zivohayon-eng/Manual-Adjustable-Workpiece-Fixture/Images/Analysis/LeadScrew__FOS.jpg

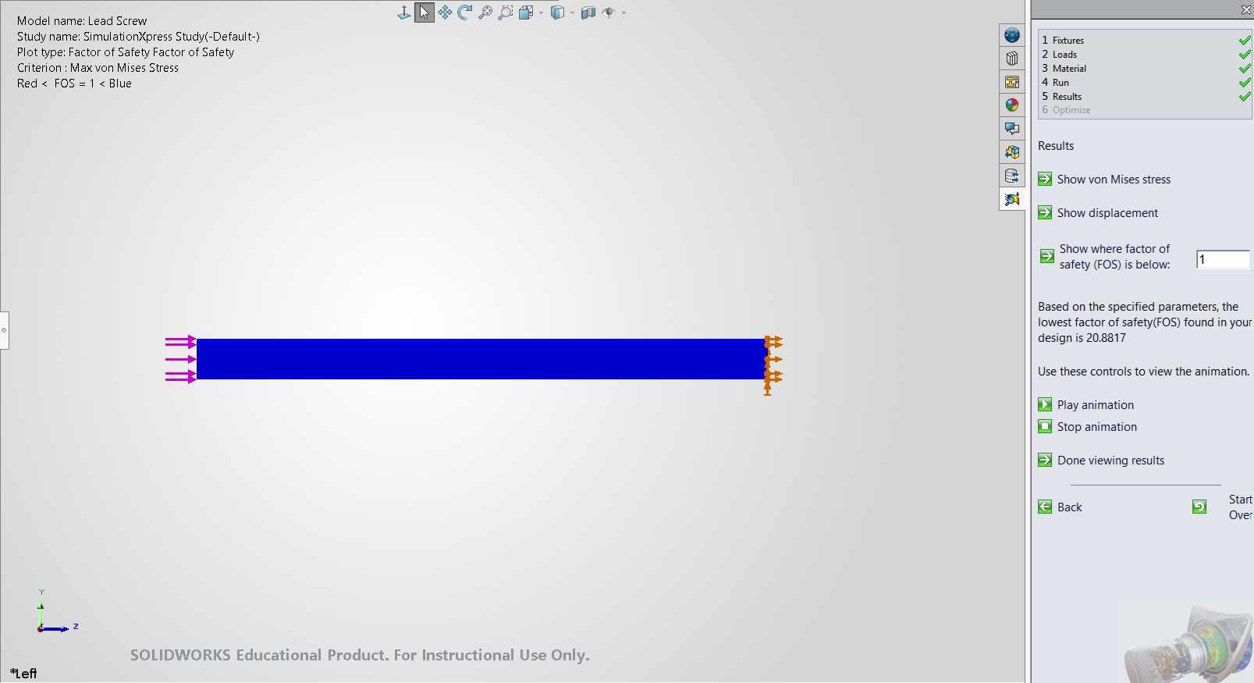
Images/Analysis/LeadScrew__FOS.jpg
