zivohayon-eng/Manual-Adjustable-Workpiece-Fixture/Images/Analysis/LeadScrew_Displacement.jpg

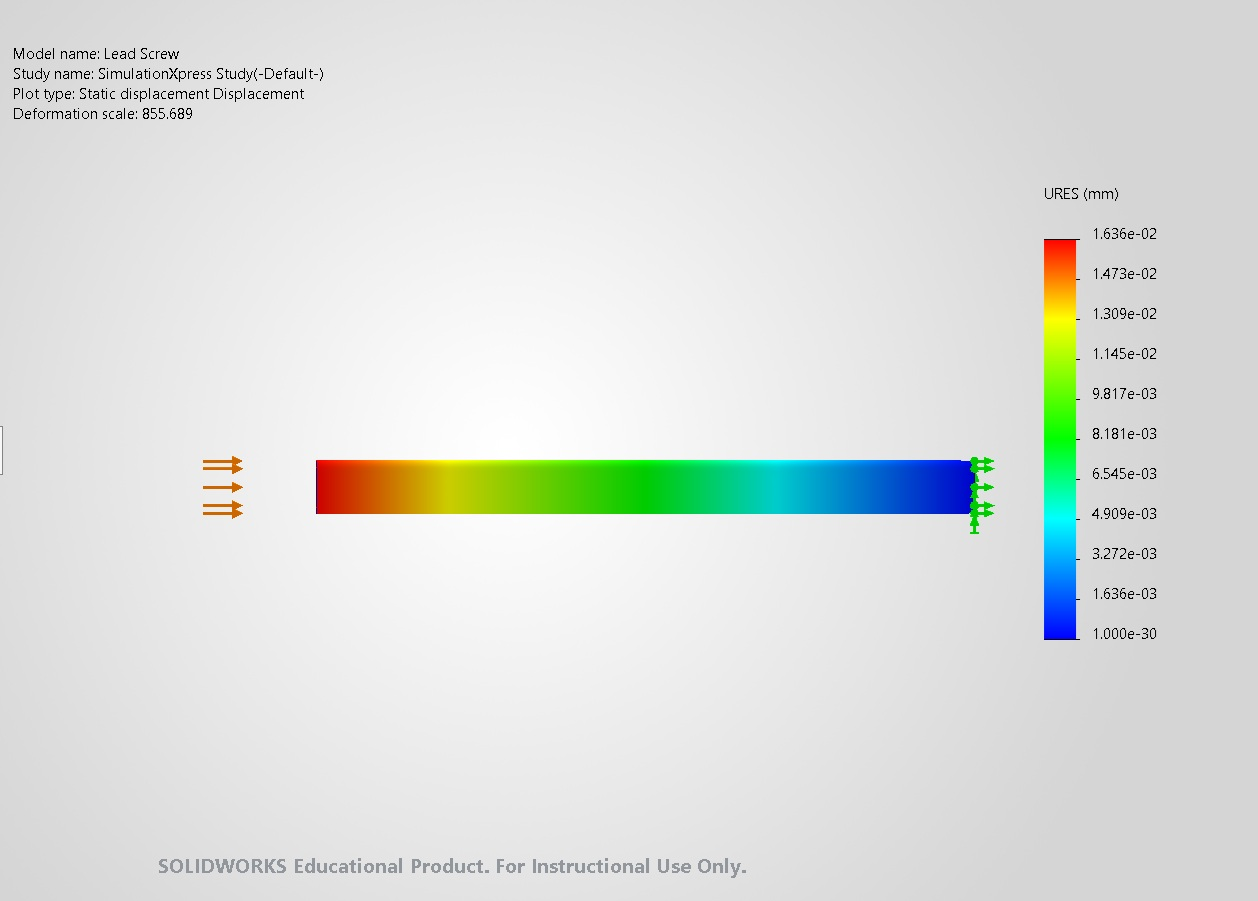
Images/Analysis/LeadScrew_Displacement.jpg
