zivohayon-eng/Manual-Adjustable-Workpiece-Fixture/Images/Analysis/LeadScrew_FoS.jpg

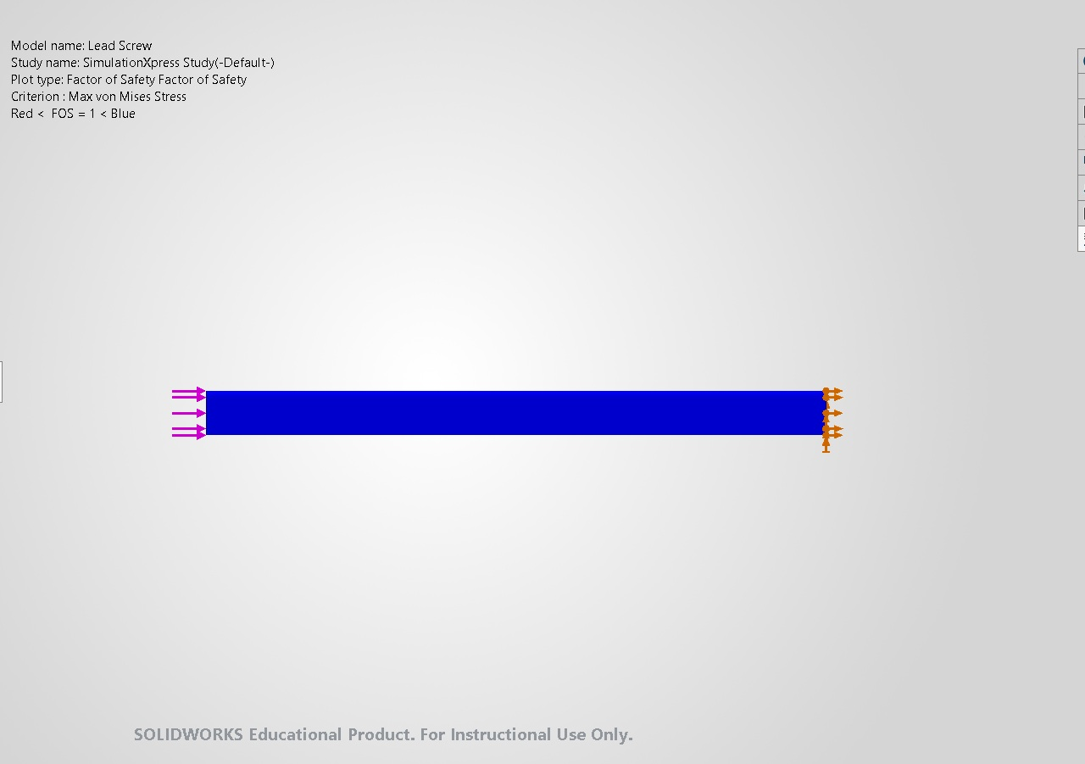
Images/Analysis/LeadScrew_FoS.jpg
