zivohayon-eng/Manual-Adjustable-Workpiece-Fixture/Images/Analysis/LeadScrew_VonMises_Stress.jpg

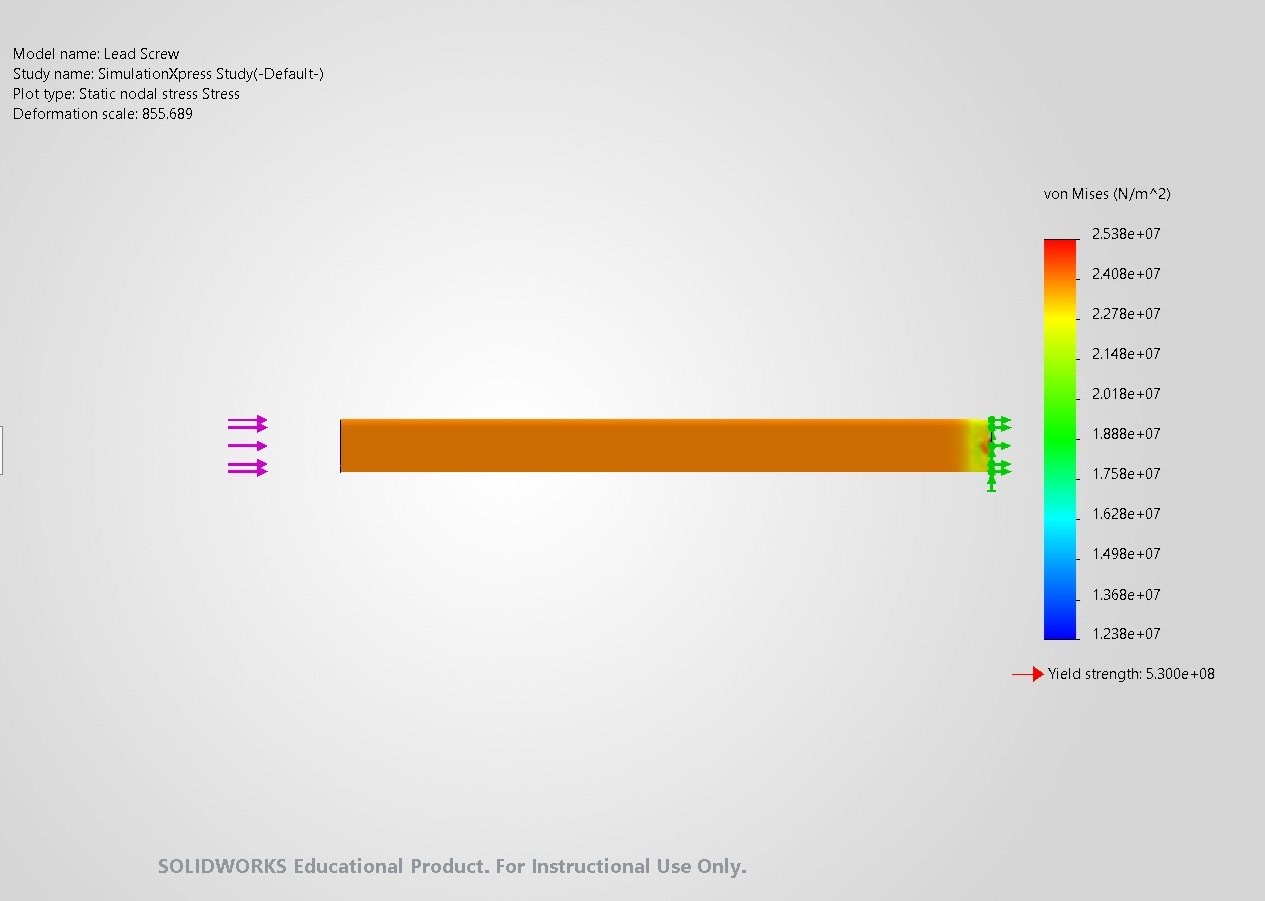
Images/Analysis/LeadScrew_VonMises_Stress.jpg
