zivohayon-eng/Manual-Adjustable-Workpiece-Fixture/Images/Handle.jpg

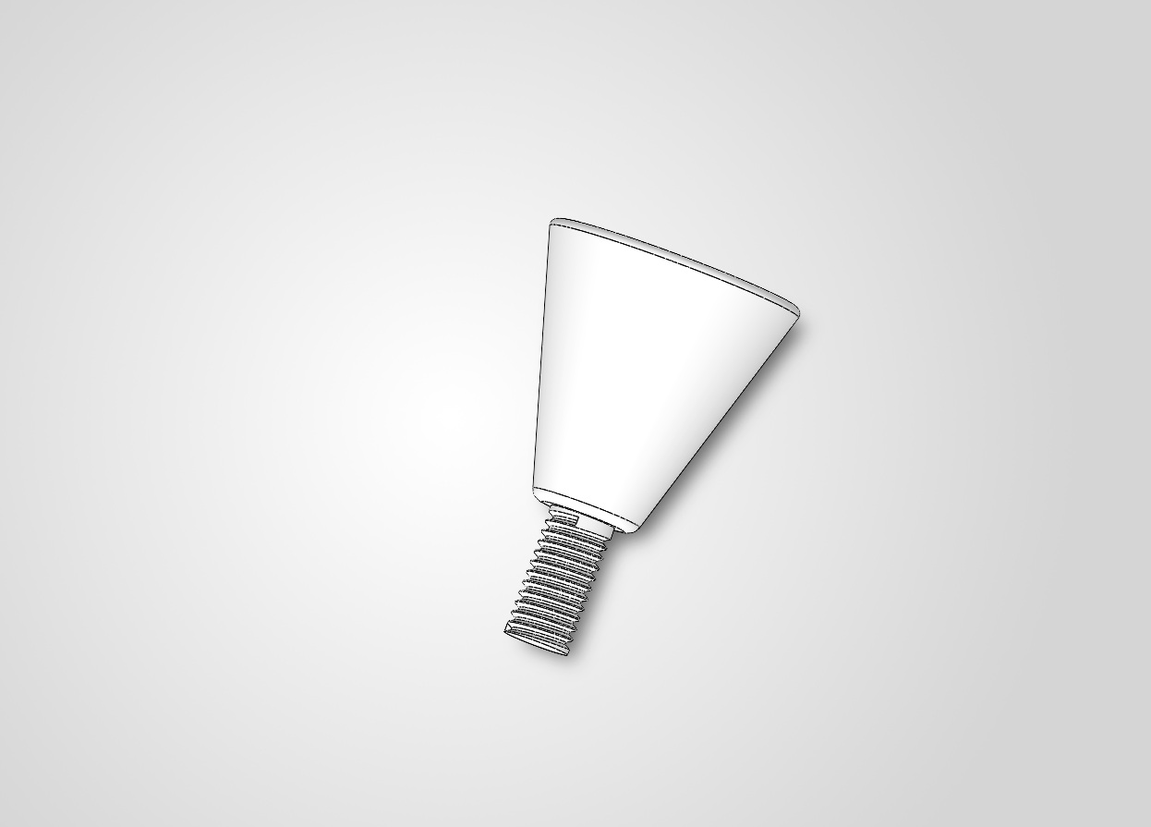
Images/Handle.jpg
