zivohayon-eng/Manual-Adjustable-Workpiece-Fixture/Images/LeadScrew.jpg

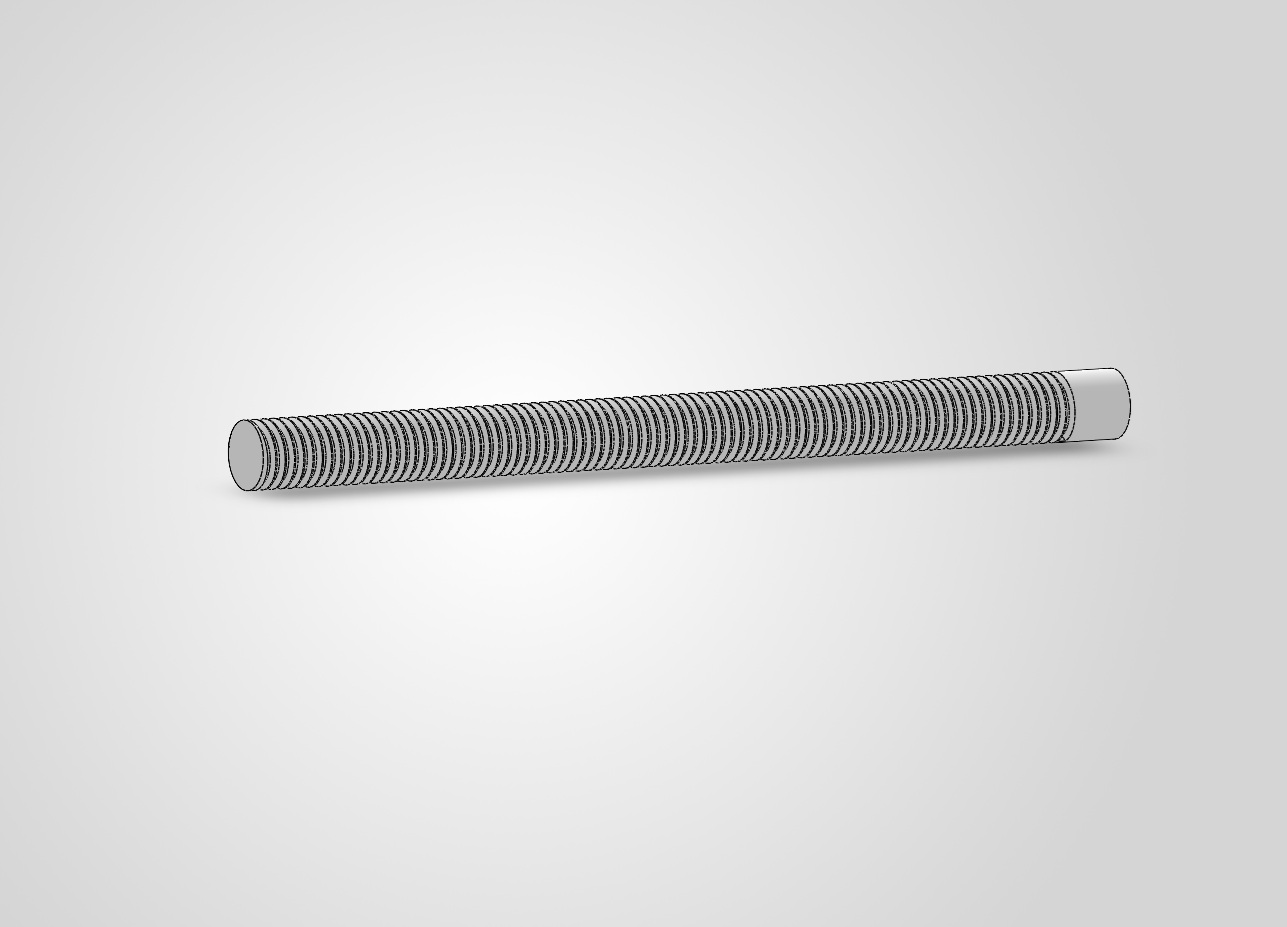
Images/LeadScrew.jpg
