zivohayon-eng/Manual-Adjustable-Workpiece-Fixture/Images/NonMovingPart.jpg

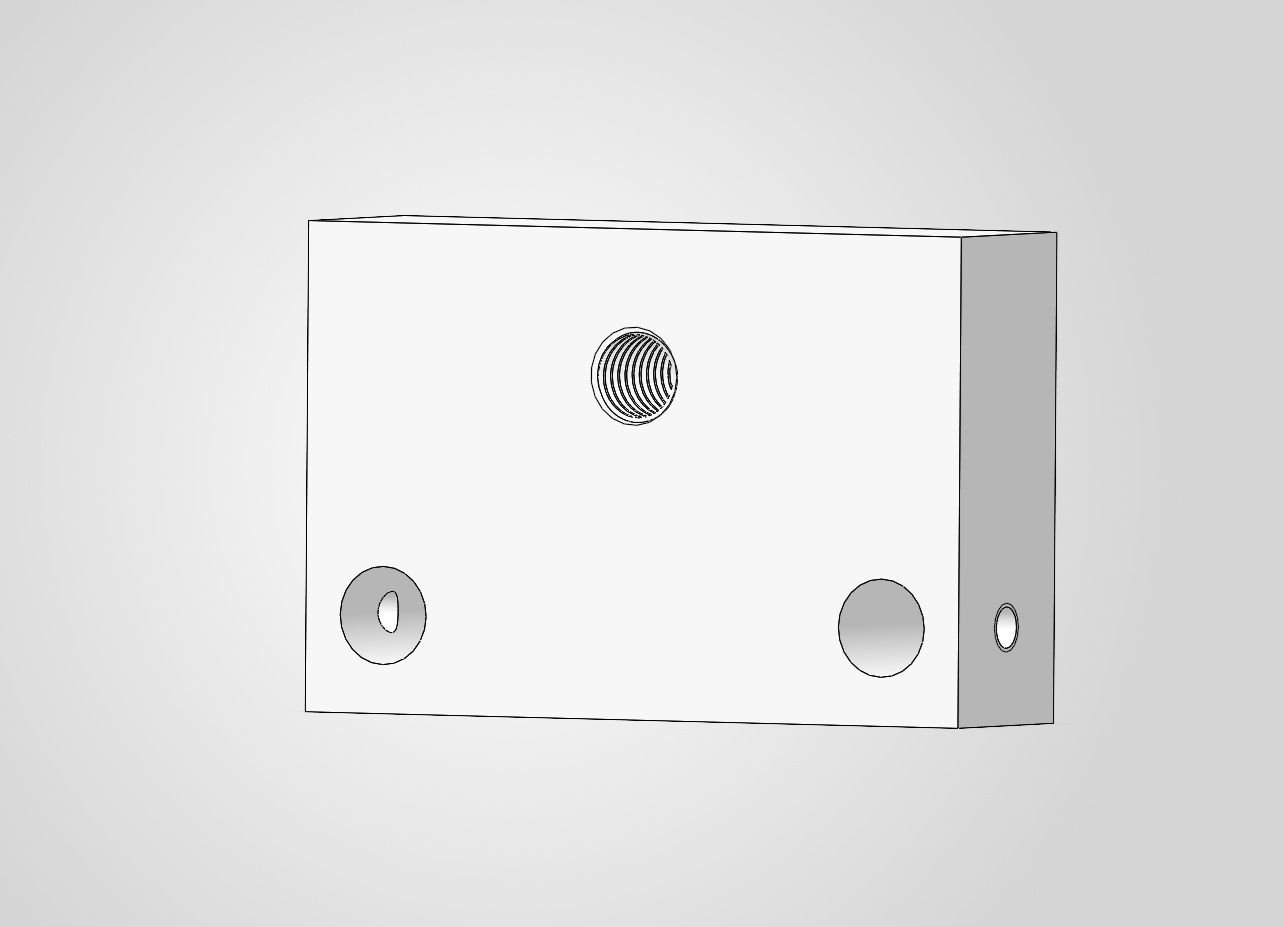
Images/NonMovingPart.jpg
