zivohayon-eng/Manual-Adjustable-Workpiece-Fixture/Images/Wheel.jpg

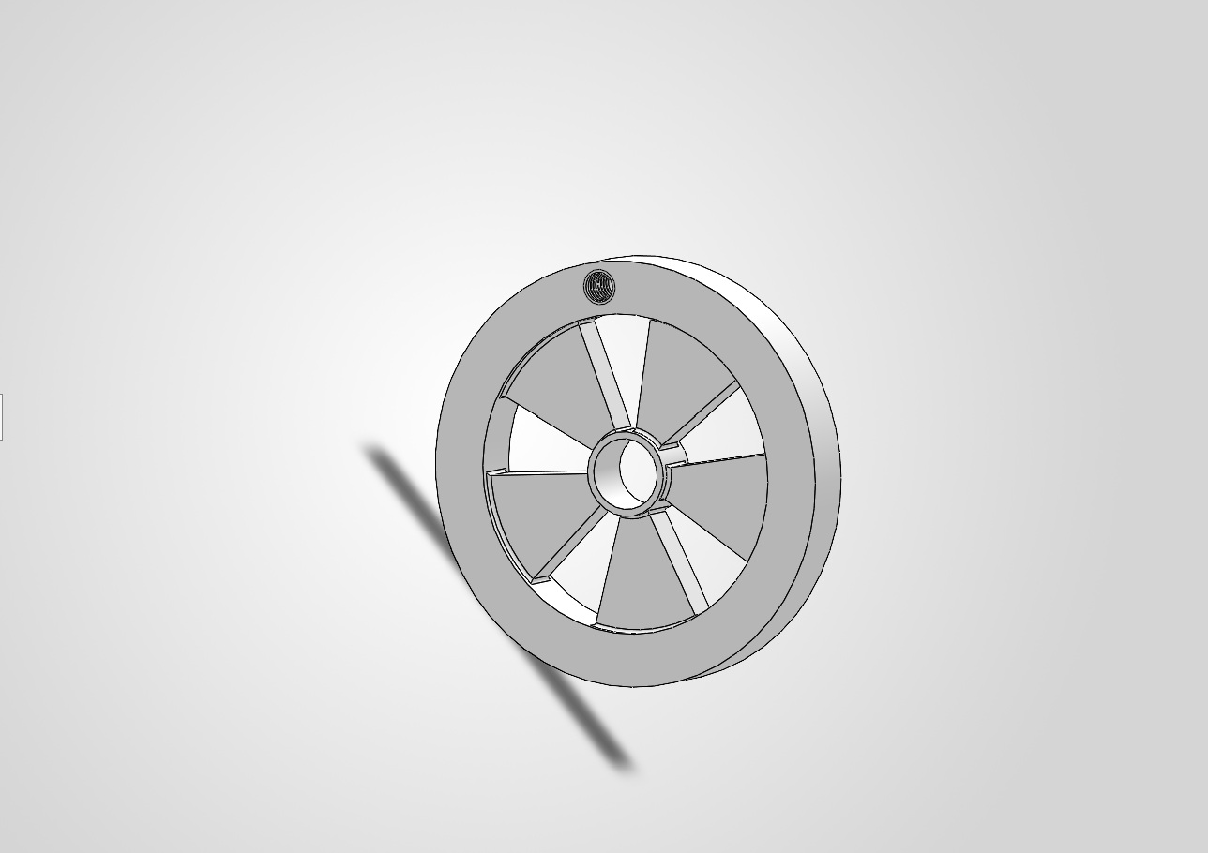
Images/Wheel.jpg
