zivohayon-eng/Manual-Adjustable-Workpiece-Fixture/SolidWorks/Explode_View.SLDASM

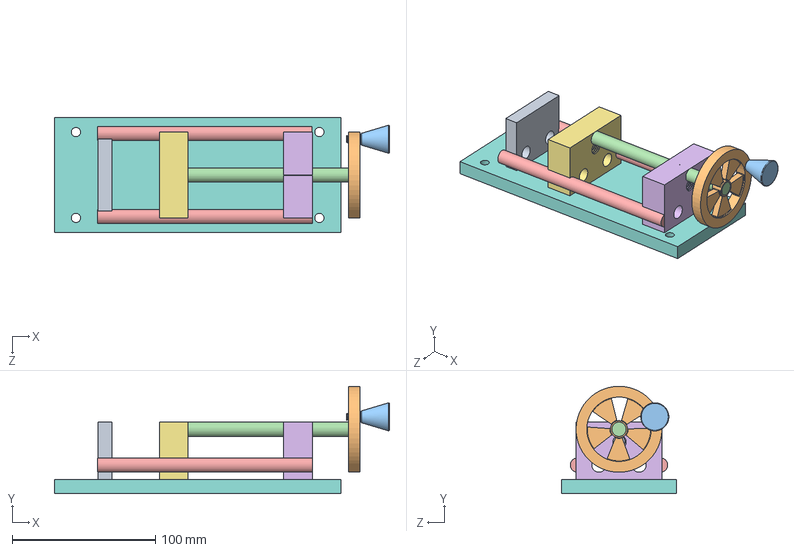
[picture p23: CAD file, 2026-10-12]
SolidWorks/Explode_View.SLDASM
234.0 x 75.0 x 80.0 mm
Base_Plate
MovingPart
NonMovingPart
Guide_Rod x 2
Lead Screw
Handle
Wheel
Fixed Jaw
