zivohayon-eng/Manual-Adjustable-Workpiece-Fixture/SolidWorks/AssemReady.SLDASM

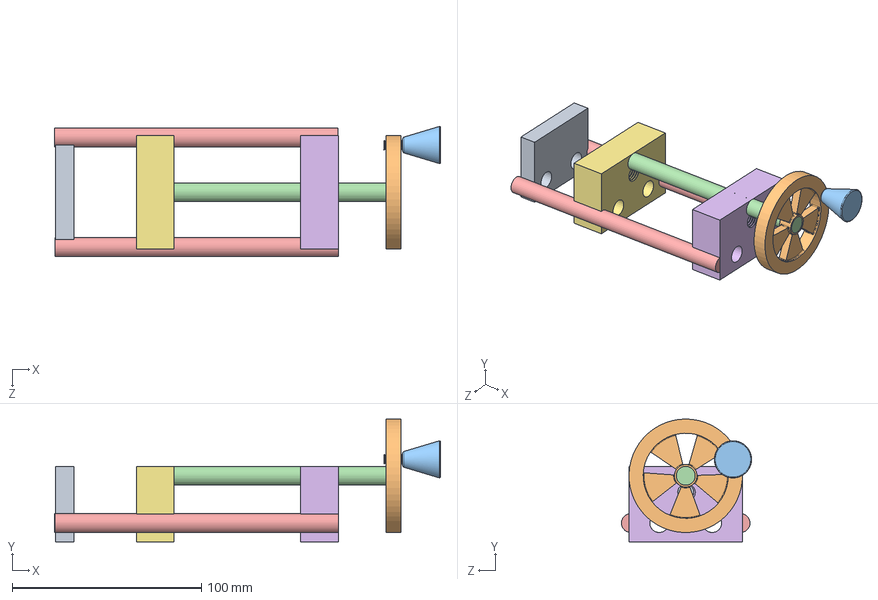
[picture p24: CAD file, 2026-10-12]
SolidWorks/AssemReady.SLDASM
204.1 x 65.0 x 68.8 mm
MovingPart
NonMovingPart
Guide_Rod x 2
Lead Screw
Handle
Wheel
Fixed Jaw
