zivohayon-eng/Manual-Adjustable-Workpiece-Fixture/SolidWorks/AssemWheel_Handle_Good.SLDASM

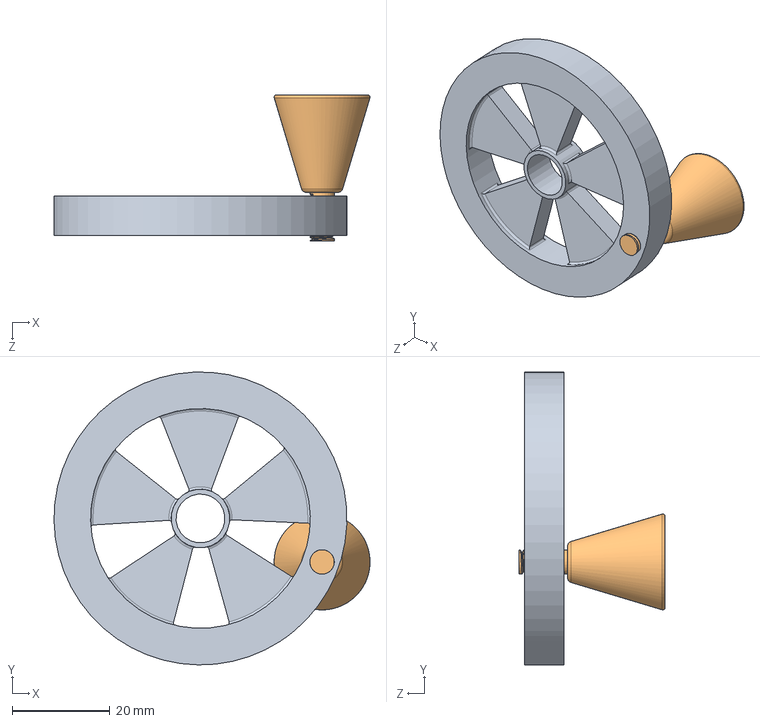
[picture p25: CAD file, 2026-10-12]
SolidWorks/AssemWheel_Handle_Good.SLDASM
64.7 x 60.0 x 30.0 mm
Handle
Wheel
