zivohayon-eng/Manual-Adjustable-Workpiece-Fixture/SolidWorks/Base_Plate.SLDPRT

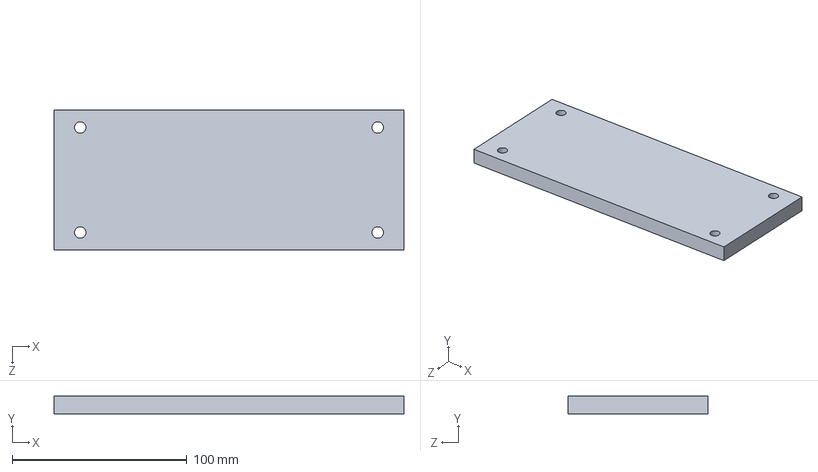
[picture p26: CAD file, 2026-10-12]
SolidWorks/Base_Plate.SLDPRT
200.0 x 10.0 x 80.0 mm
