zivohayon-eng/Manual-Adjustable-Workpiece-Fixture/SolidWorks/Fixed_Jaw_New.SLDPRT

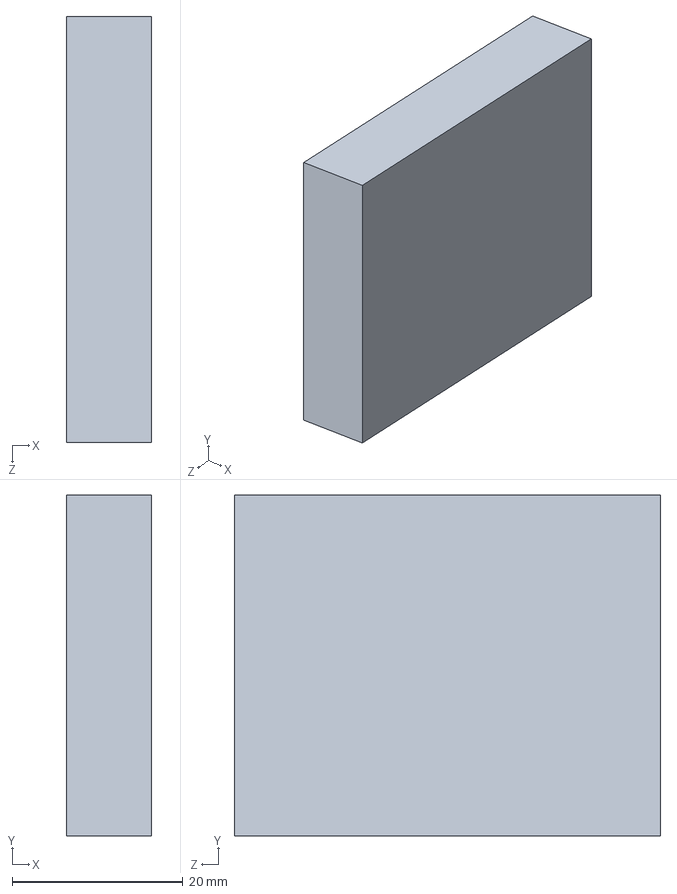
[picture p27: CAD file, 2026-10-12]
SolidWorks/Fixed_Jaw_New.SLDPRT
10.0 x 40.0 x 50.0 mm
