zivohayon-eng/Manual-Adjustable-Workpiece-Fixture/SolidWorks/MovingPart.SLDPRT

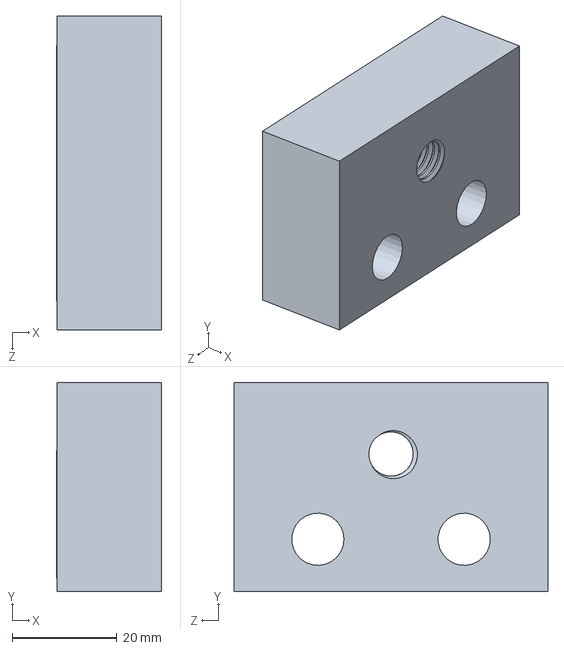
[picture p28: CAD file, 2026-10-12]
SolidWorks/MovingPart.SLDPRT
20.0 x 40.0 x 60.0 mm
