zivohayon-eng/Manual-Adjustable-Workpiece-Fixture/SolidWorks/Fixed Jaw.SLDPRT

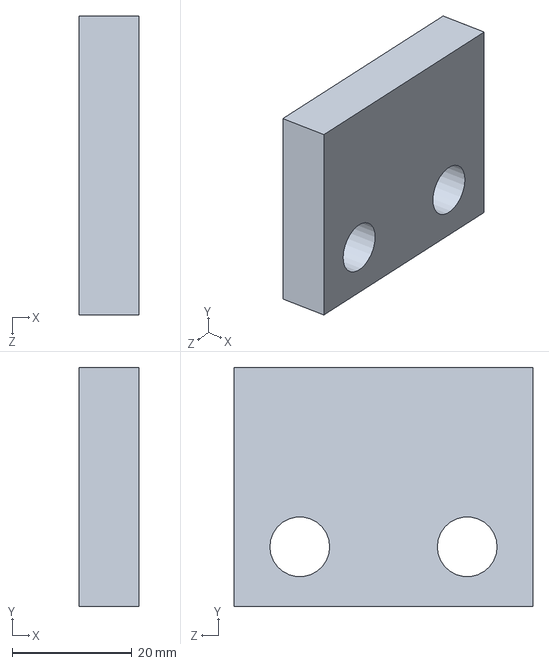
[picture p29: CAD file, 2026-10-12]
SolidWorks/Fixed Jaw.SLDPRT
10.0 x 40.0 x 50.0 mm
