zivohayon-eng/Manual-Adjustable-Workpiece-Fixture/SolidWorks/AssemAlmostReady.STEP

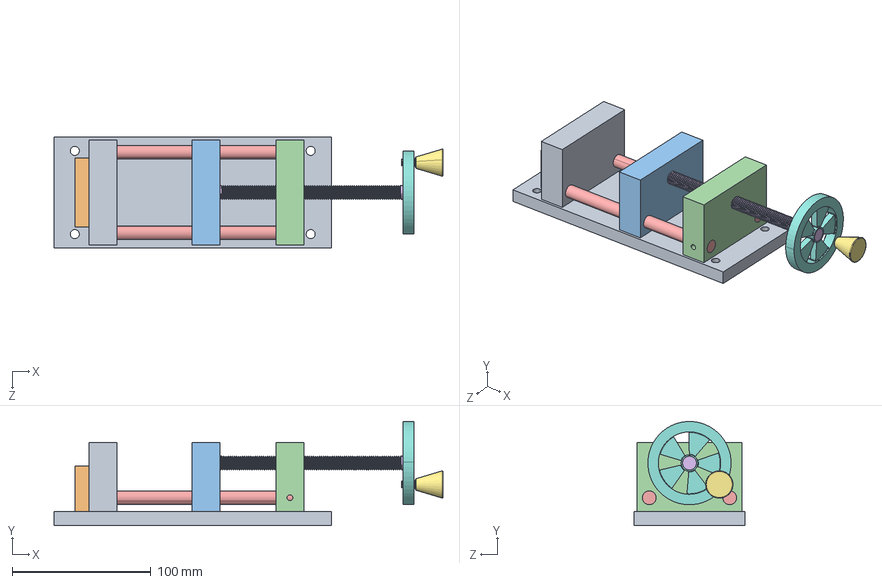
[picture p30: CAD file, 2026-10-12]
SolidWorks/AssemAlmostReady.STEP
280.4 x 75.0 x 80.0 mm
Bass2
Fixed Jaw2
MovingPart
NonMovingPart
Guide_Rod x 2
Lead Screw
Handle
Wheel
Fixed Jaw
