zivohayon-eng/Manual-Adjustable-Workpiece-Fixture/SolidWorks/Handle.SLDPRT

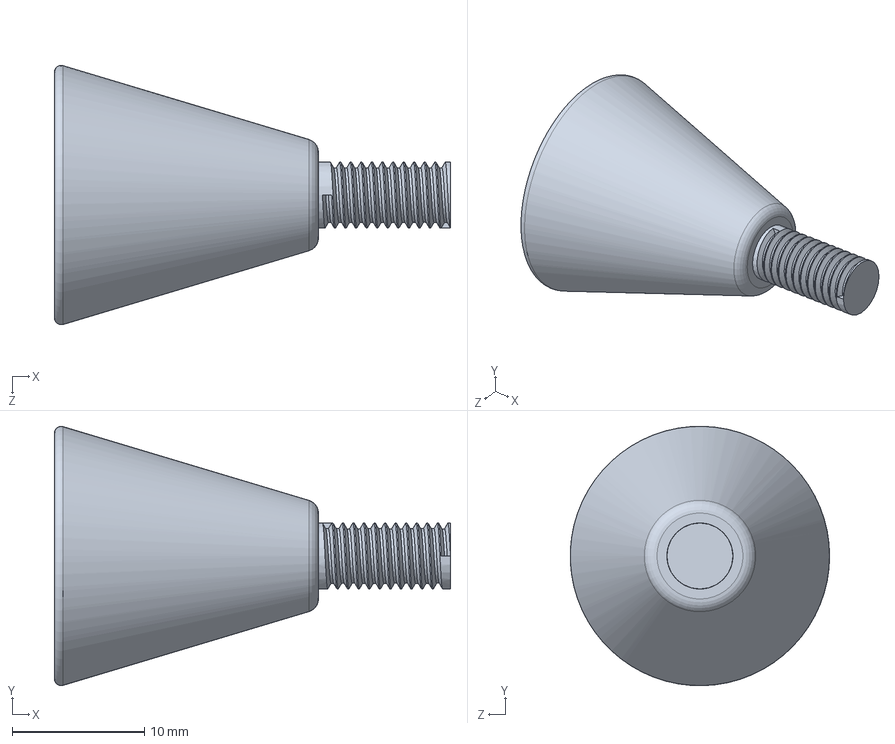
[picture p31: CAD file, 2026-10-12]
SolidWorks/Handle.SLDPRT
30.0 x 19.6 x 19.6 mm
