zivohayon-eng/Manual-Adjustable-Workpiece-Fixture/SolidWorks/Guide_Rod.SLDPRT

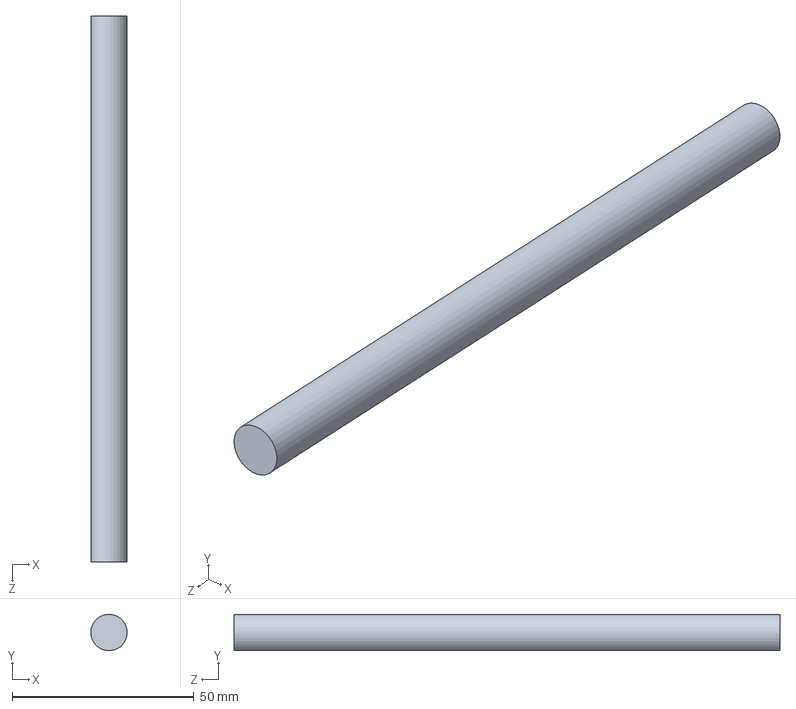
[picture p32: CAD file, 2026-10-12]
SolidWorks/Guide_Rod.SLDPRT
10.0 x 9.99 x 150.0 mm
