zivohayon-eng/Manual-Adjustable-Workpiece-Fixture/SolidWorks/Wheel.SLDPRT

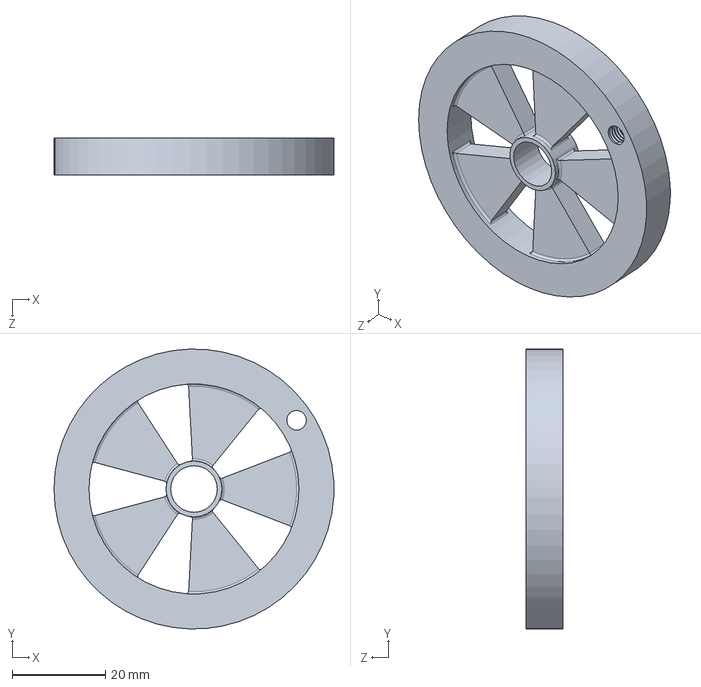
[picture p33: CAD file, 2026-10-12]
SolidWorks/Wheel.SLDPRT
60.0 x 60.0 x 8.00 mm
