zivohayon-eng/Manual-Adjustable-Workpiece-Fixture/SolidWorks/Lead Screw.SLDPRT

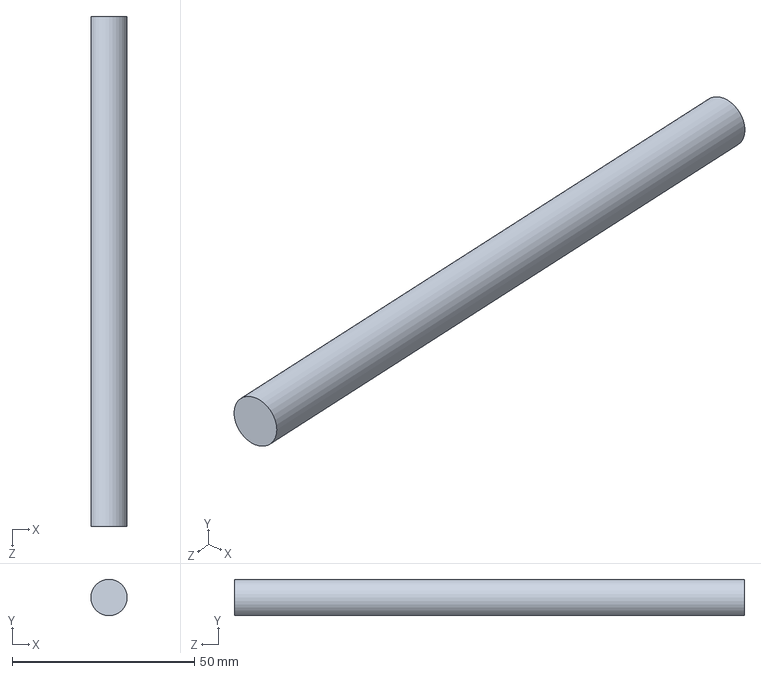
[picture p34: CAD file, 2026-10-12]
SolidWorks/Lead Screw.SLDPRT
10.0 x 10.0 x 140.0 mm
