zivohayon-eng/Manual-Adjustable-Workpiece-Fixture/(list of files, cad)

Other CAD files:
SolidWorks/NonMovingPart.SLDPRT
Drawings/Base_Plate_Drawing.SLDDRW
Drawings/Explode_View_Drawing.SLDDRW
Drawings/Fixed_Jaw_New_Drawing.SLDDRW
Drawings/Handle_Drawing.SLDDRW
Drawings/Isometric_Drawing.SLDDRW
Drawings/Lead_Screw_Drawing.SLDDRW
Drawings/MovingPart_Drawing.SLDDRW
Drawings/NonMovingPart_Drawing.SLDDRW
Drawings/Wheel_Drawing.SLDDRW
SolidWorks/AssemReady_ANSYS.x_t
SolidWorks/AssemReady_ANSYS_Simplified.x_t
