zivohayon-eng/Manual-Adjustable-Workpiece-Fixture/Images/Analysis/GuideRod_FOS.jpg

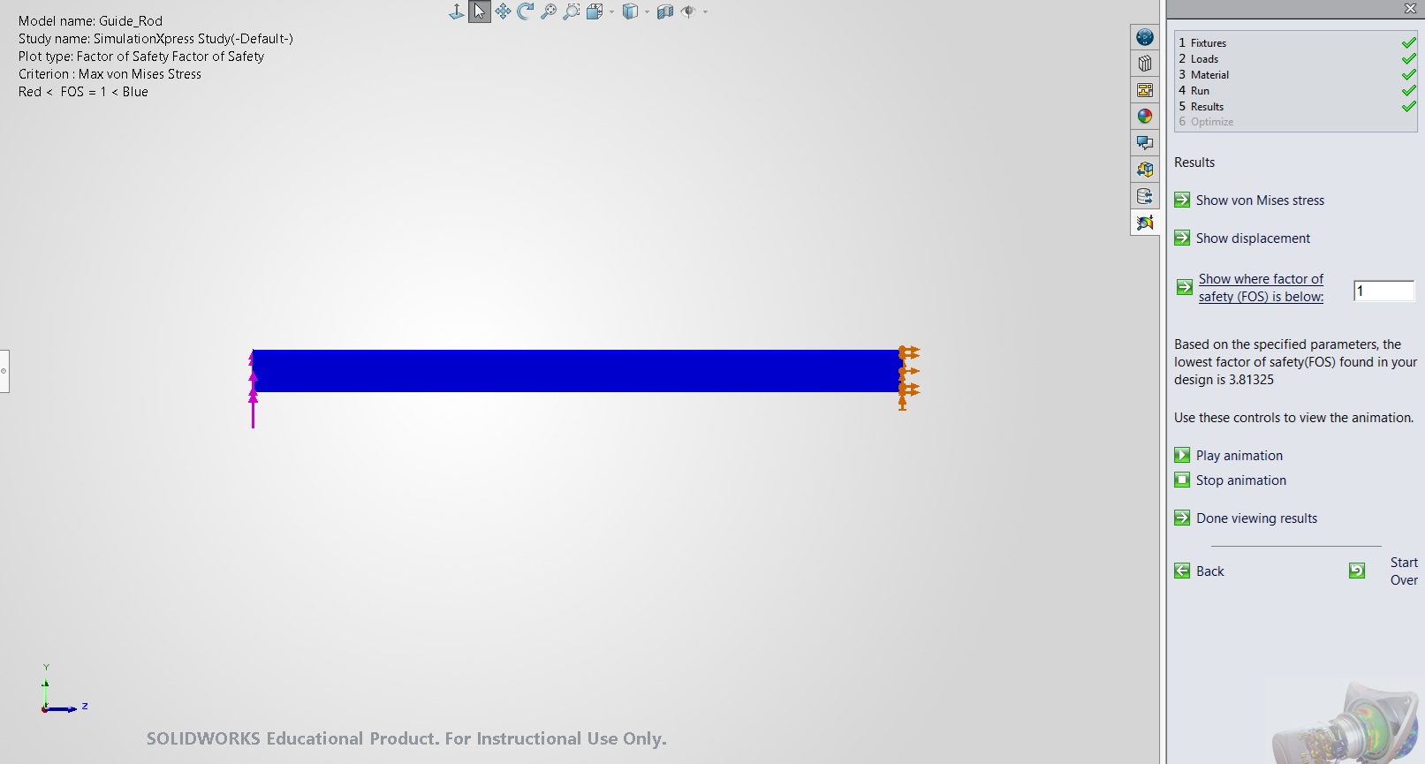
Images/Analysis/GuideRod_FOS.jpg
