zivohayon-eng/Manual-Adjustable-Workpiece-Fixture/Images/Analysis/GuideRod_VonMises_Stress.jpg

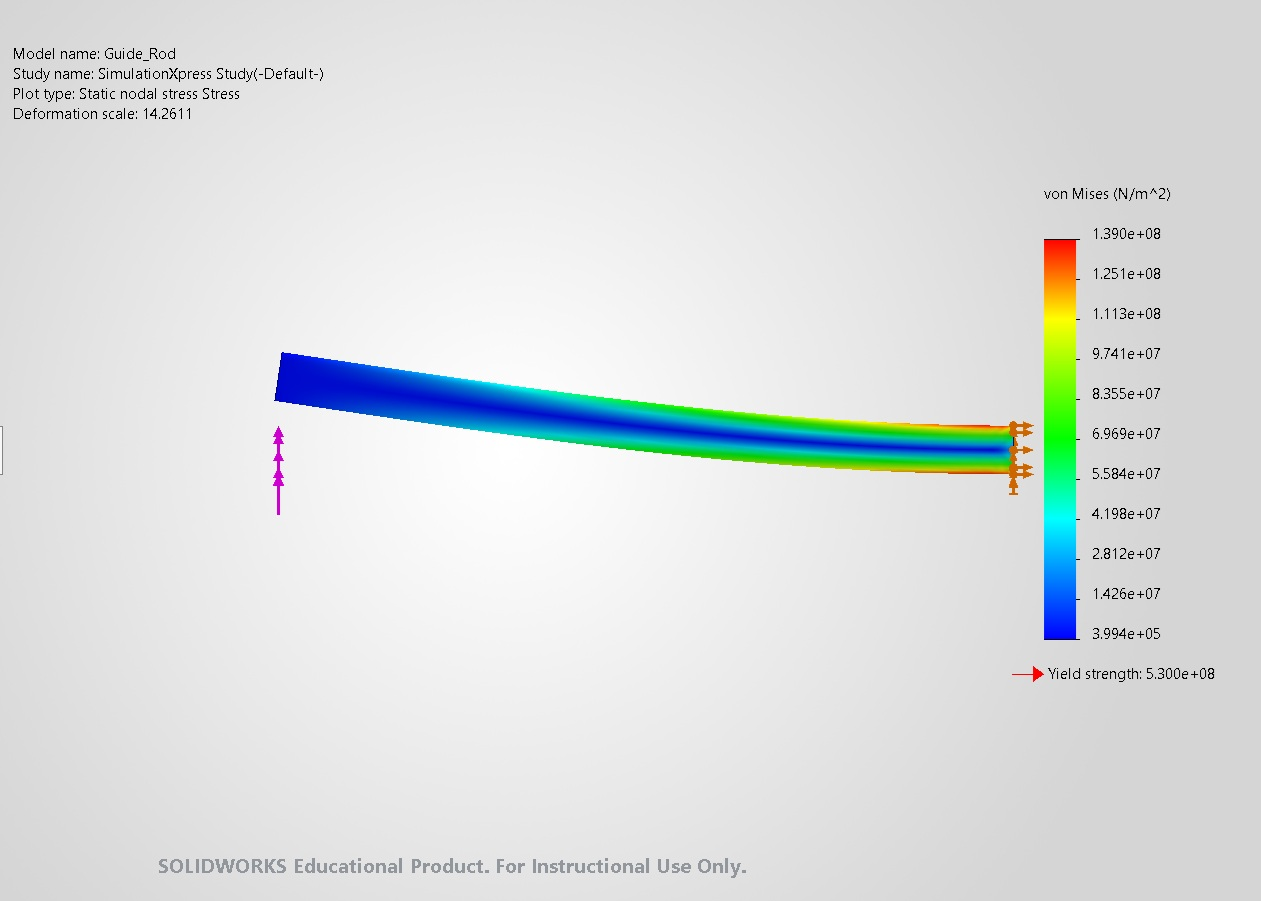
Images/Analysis/GuideRod_VonMises_Stress.jpg
